dobneyresearch/PredictiveCodingNetworks_AnalogVLSIdesign/PCNchip_design/sim/results/c1_cell_transfer.png

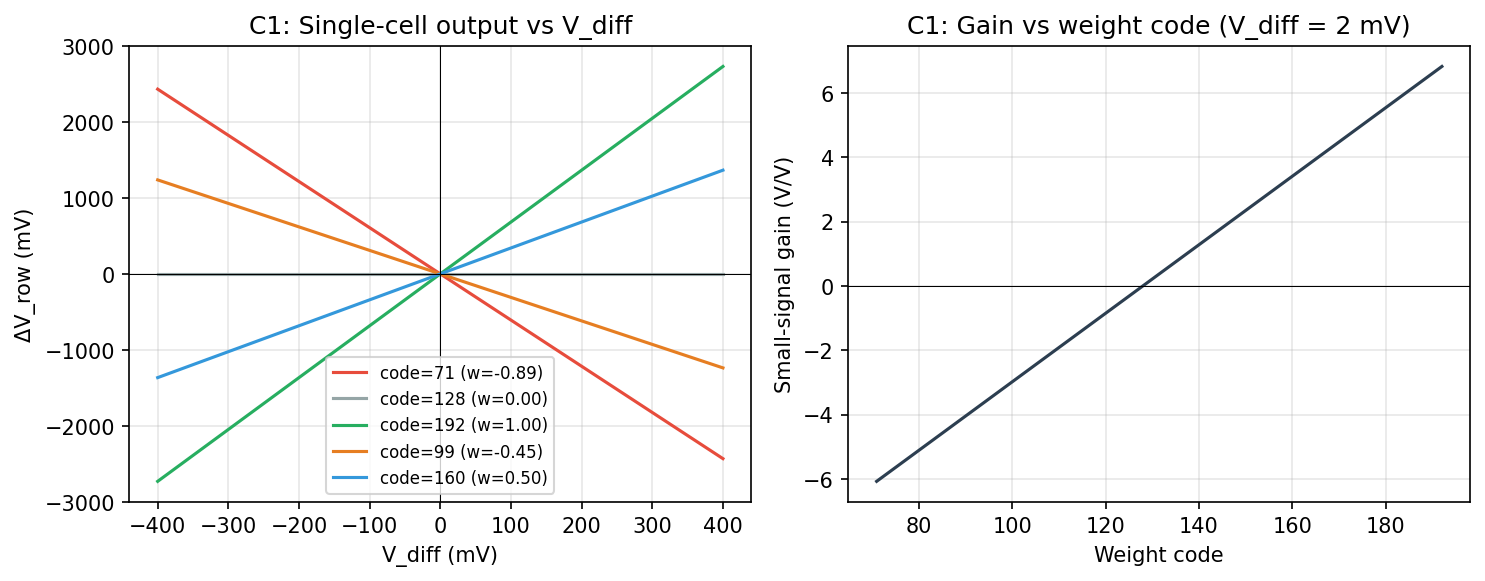
PCNchip_design/sim/results/c1_cell_transfer.png
