dobneyresearch/PredictiveCodingNetworks_AnalogVLSIdesign/PCNchip_design/sim/results/c2_kcl_summation.png

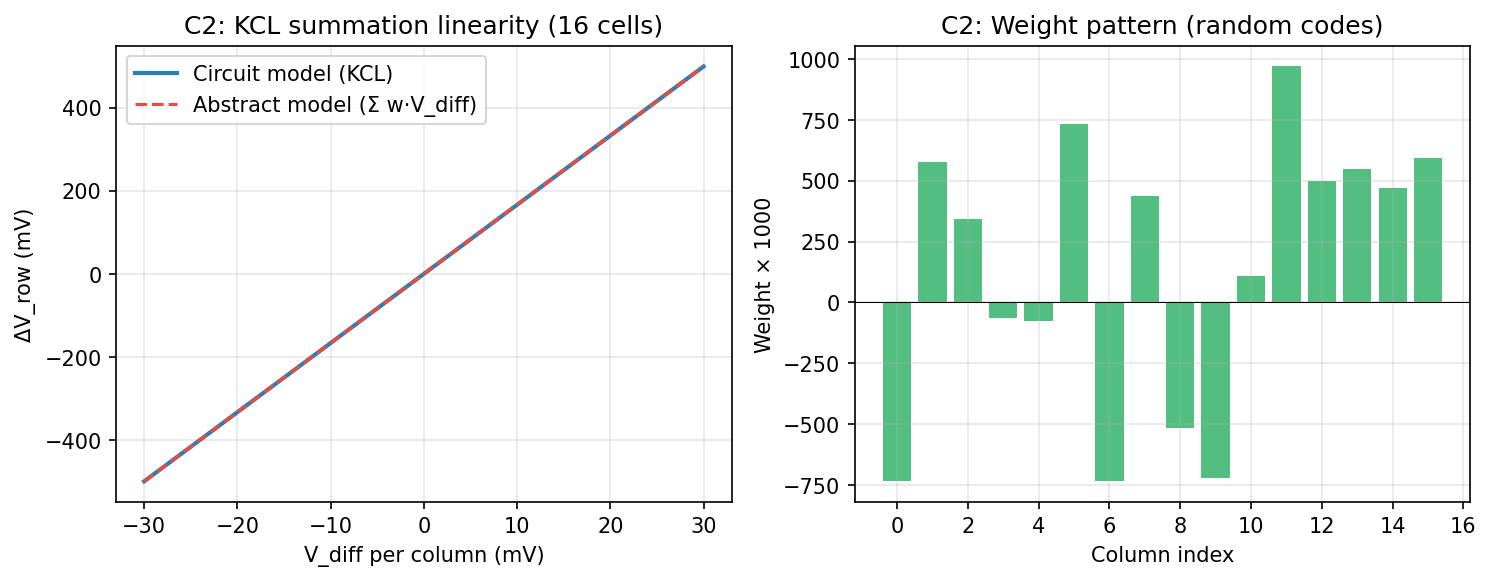
PCNchip_design/sim/results/c2_kcl_summation.png
