dobneyresearch/PredictiveCodingNetworks_AnalogVLSIdesign/PCNchip_design/sim/results/c3_spatial_cascade.png

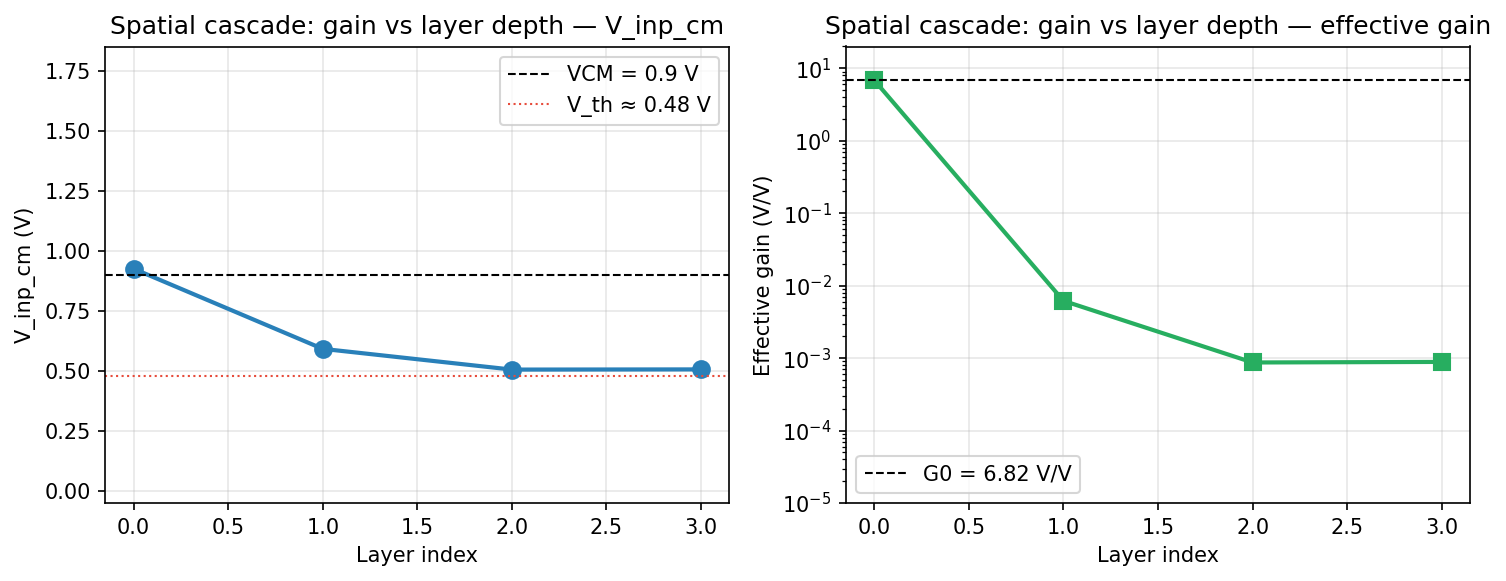
PCNchip_design/sim/results/c3_spatial_cascade.png
