dobneyresearch/PredictiveCodingNetworks_AnalogVLSIdesign/PCNchip_design/sim/results/c4_temporal_cascade.png

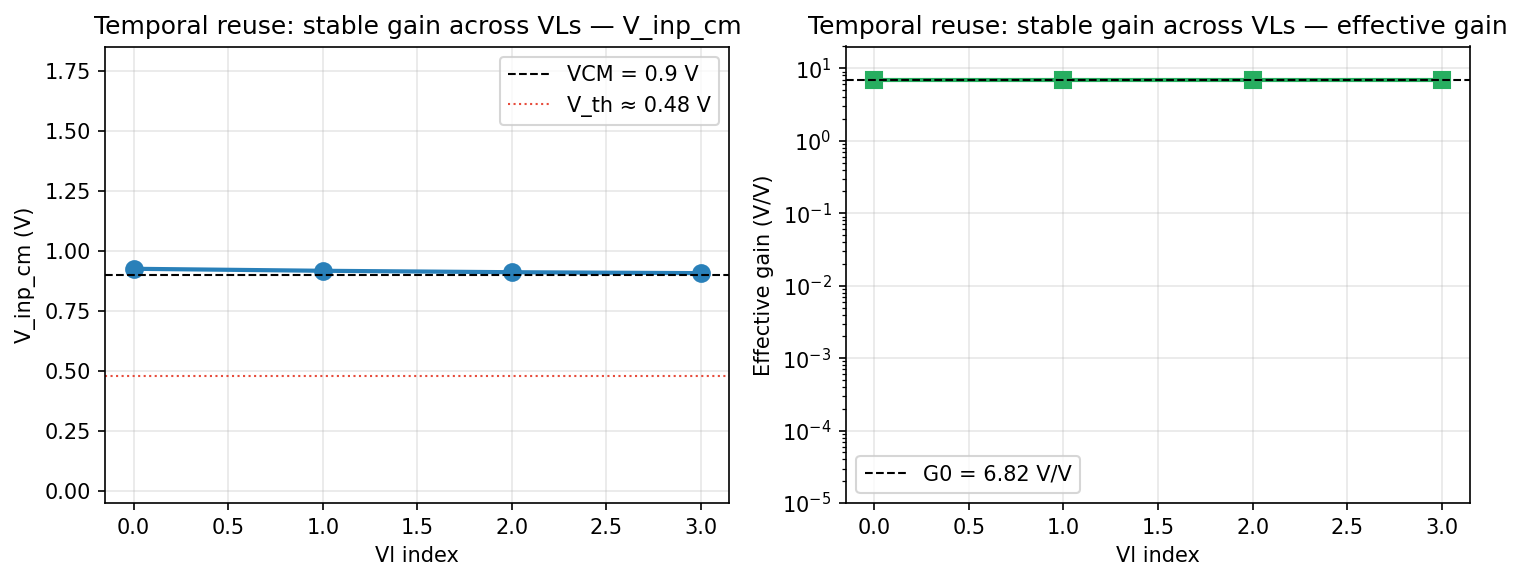
PCNchip_design/sim/results/c4_temporal_cascade.png
