dobneyresearch/PredictiveCodingNetworks_AnalogVLSIdesign/PCNchip_design/sim/results/c5_spatial_vs_temporal.png

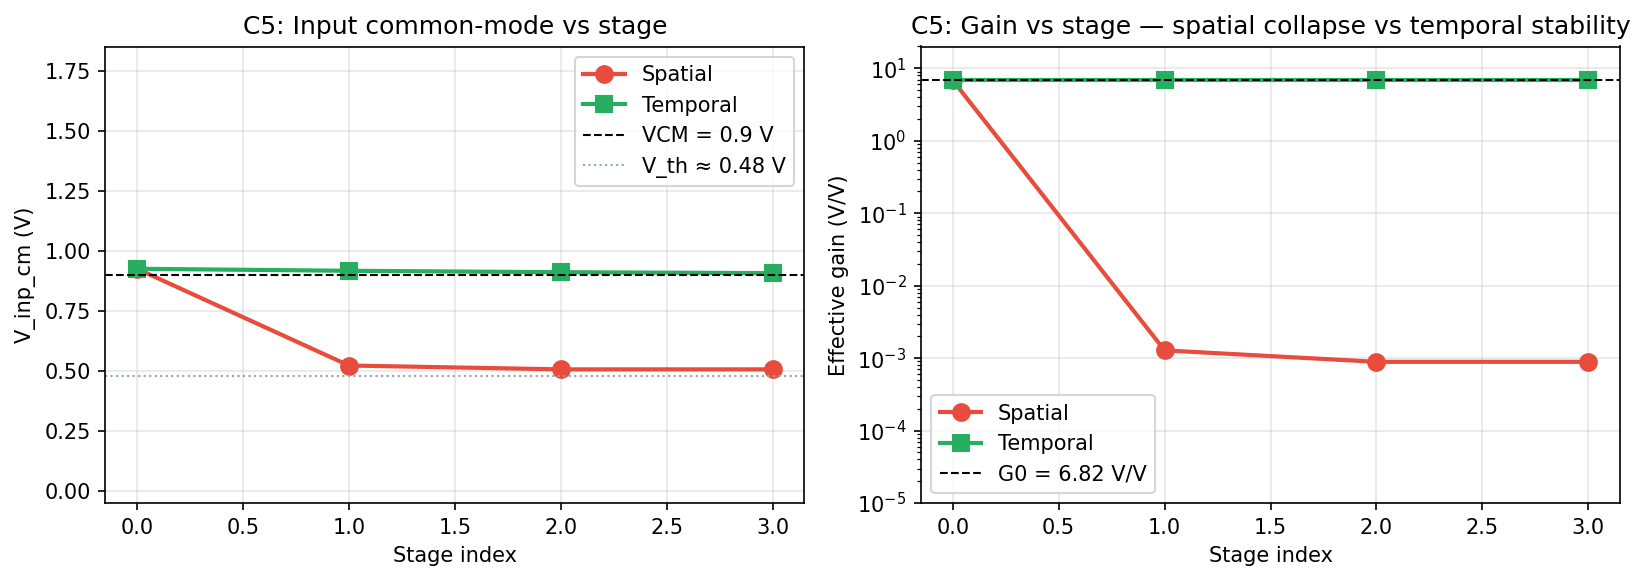
PCNchip_design/sim/results/c5_spatial_vs_temporal.png
