dobneyresearch/PredictiveCodingNetworks_AnalogVLSIdesign/PCNchip_design/sim/results/c6_quant_noise.png

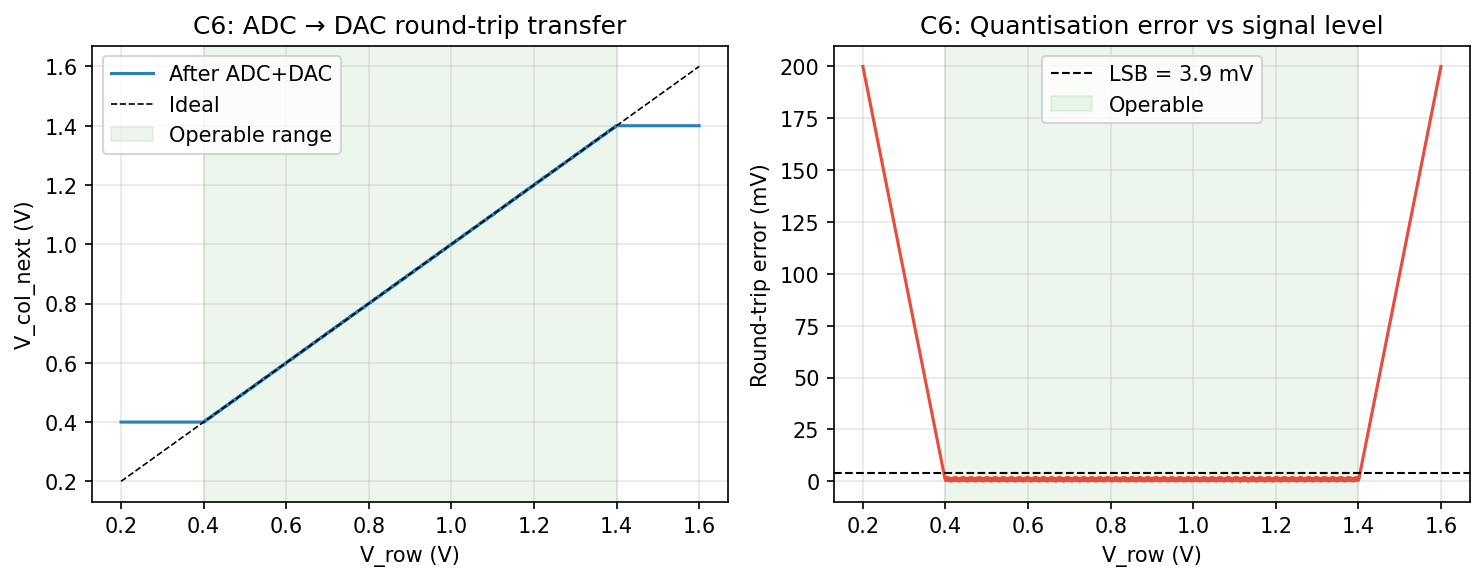
PCNchip_design/sim/results/c6_quant_noise.png
