dobneyresearch/PredictiveCodingNetworks_AnalogVLSIdesign/PCNchip_design/sim/results/c7_linearity.png

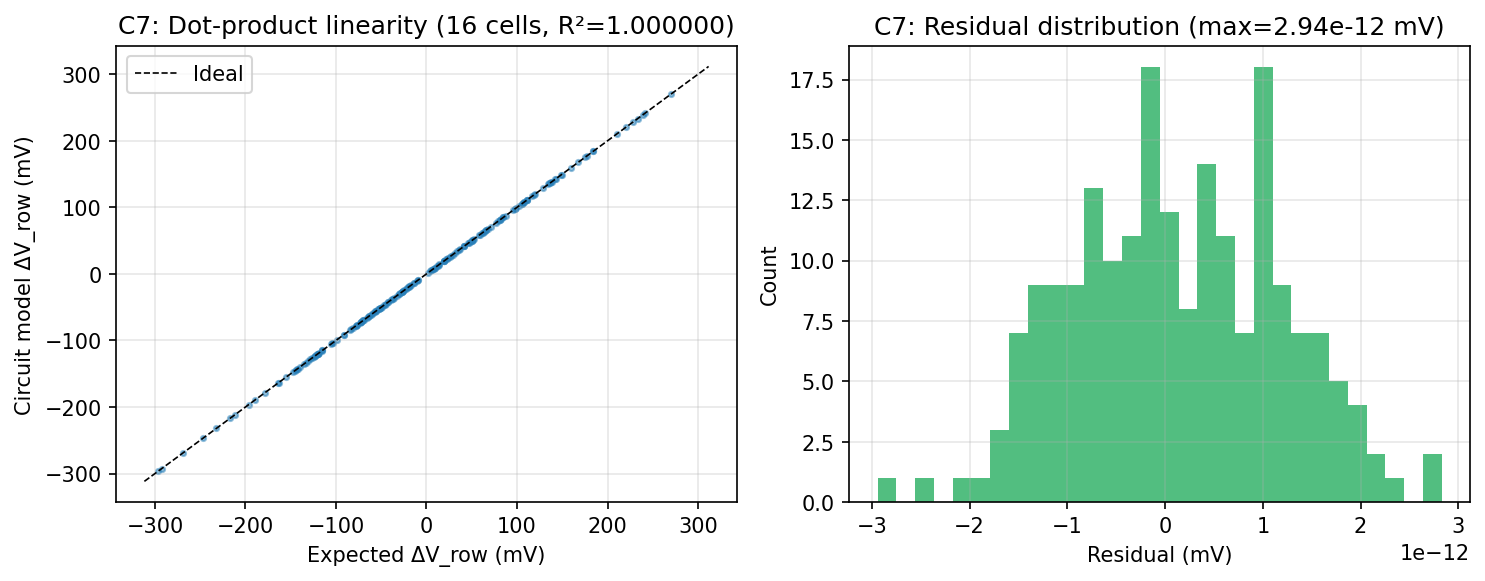
PCNchip_design/sim/results/c7_linearity.png
