dobneyresearch/PredictiveCodingNetworks_AnalogVLSIdesign/PCNchip_design/sim/results/e2_template_learning.png

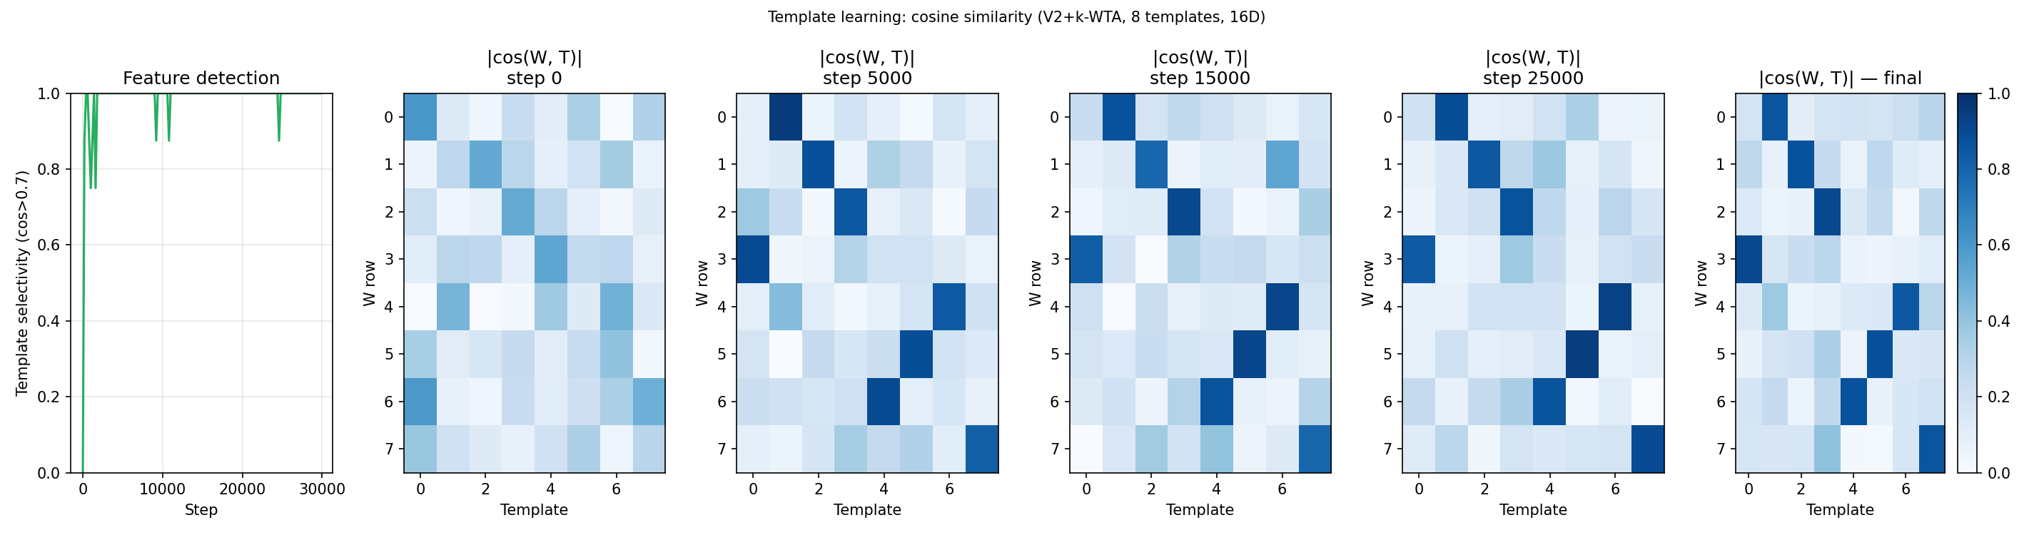
PCNchip_design/sim/results/e2_template_learning.png
