dobneyresearch/PredictiveCodingNetworks_AnalogVLSIdesign/PCNchip_design/sim/results/e3_quantisation.png

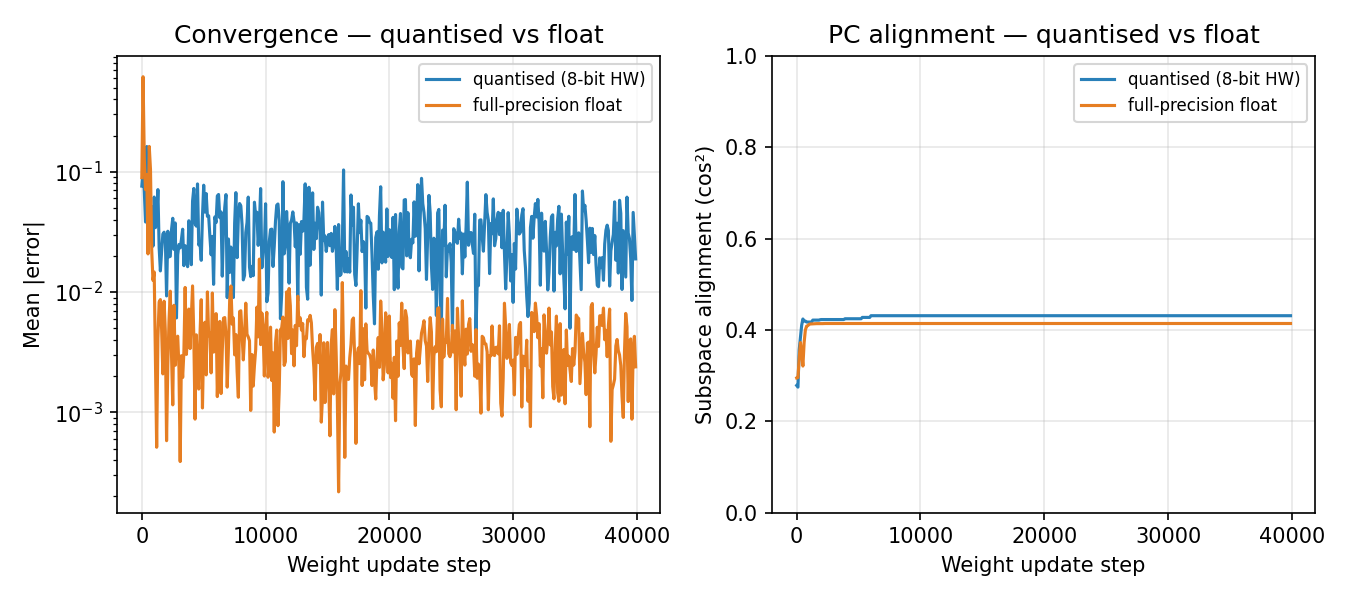
PCNchip_design/sim/results/e3_quantisation.png
