dobneyresearch/PredictiveCodingNetworks_AnalogVLSIdesign/PCNchip_design/sim/results/emnist_letters_confusion.png

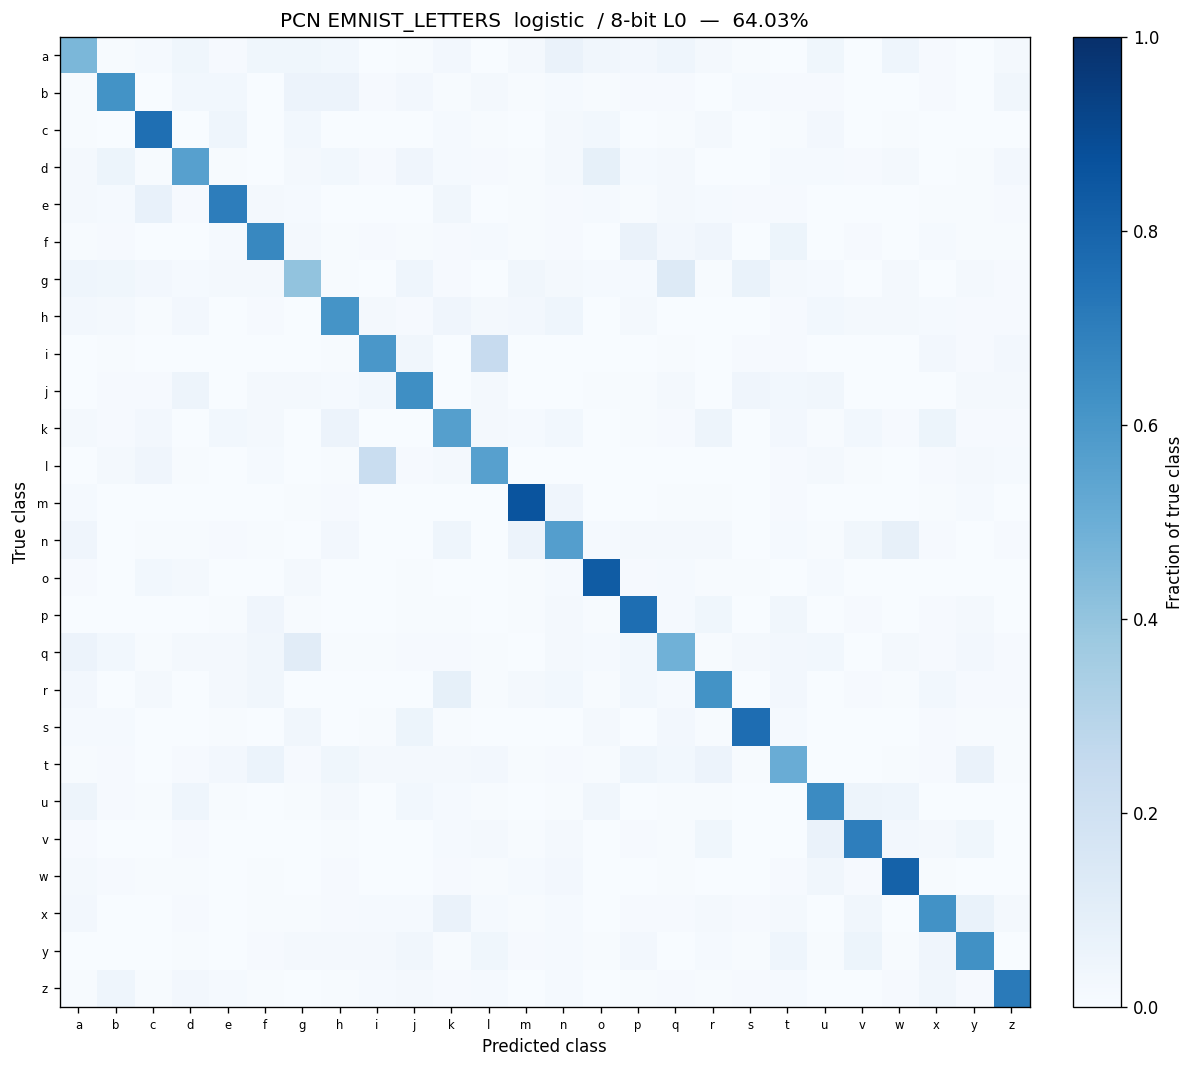
PCNchip_design/sim/results/emnist_letters_confusion.png
