dobneyresearch/PredictiveCodingNetworks_AnalogVLSIdesign/PCNchip_design/sim/results/emnist_letters_filters_l1.png

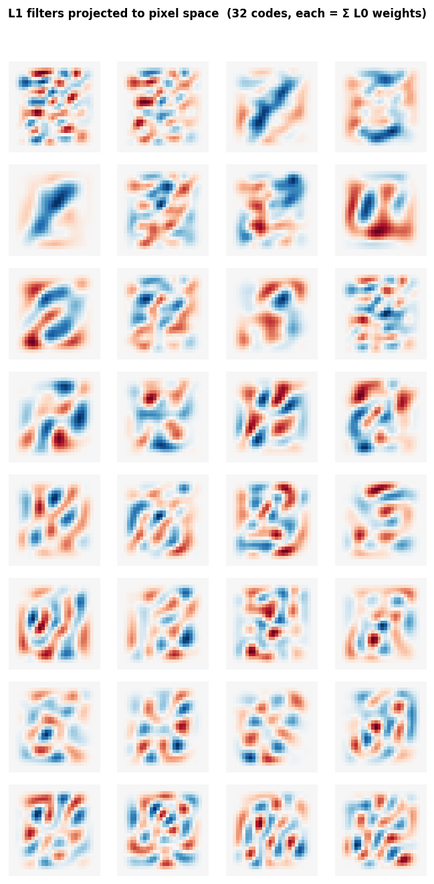
PCNchip_design/sim/results/emnist_letters_filters_l1.png
