dobneyresearch/PredictiveCodingNetworks_AnalogVLSIdesign/PCNchip_design/sim/results/emnist_letters_training.png

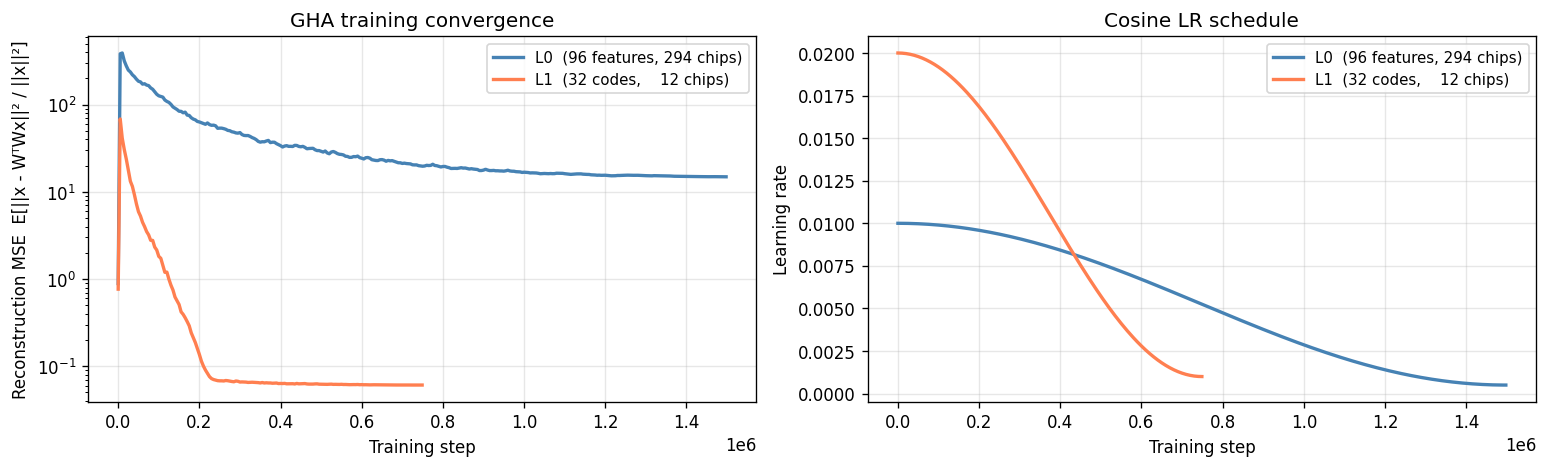
PCNchip_design/sim/results/emnist_letters_training.png
