dobneyresearch/PredictiveCodingNetworks_AnalogVLSIdesign/PCNchip_design/sim/results/mnist_confusion.png

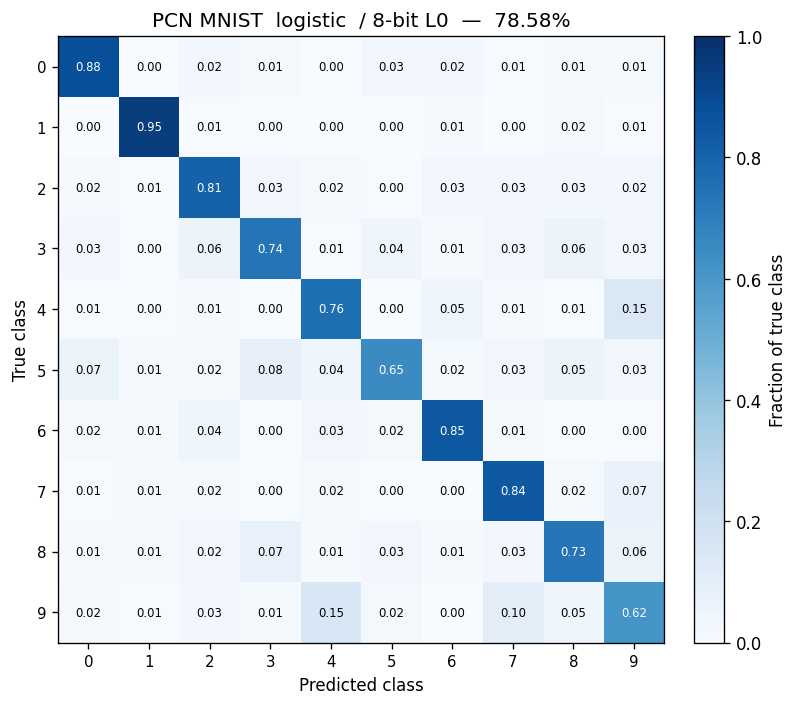
PCNchip_design/sim/results/mnist_confusion.png
