dobneyresearch/PredictiveCodingNetworks_AnalogVLSIdesign/PCNchip_design/sim/results/mnist_filters_l0.png

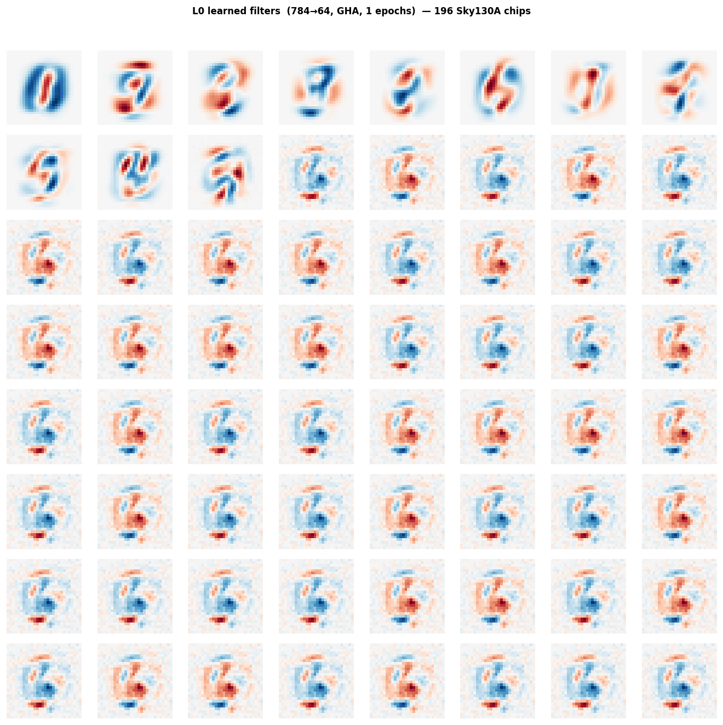
PCNchip_design/sim/results/mnist_filters_l0.png
