dobneyresearch/PredictiveCodingNetworks_AnalogVLSIdesign/PCNchip_design/sim/results/mnist_filters_l1.png

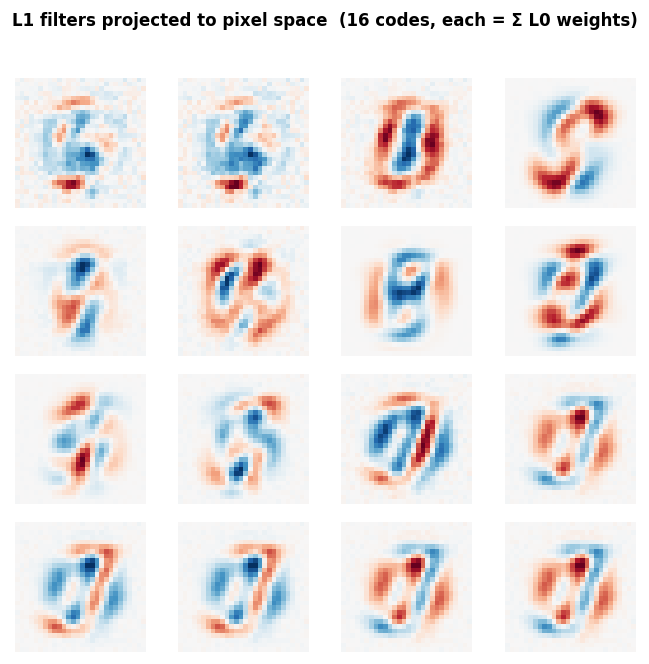
PCNchip_design/sim/results/mnist_filters_l1.png
