dobneyresearch/PredictiveCodingNetworks_AnalogVLSIdesign/PCNchip_design/sim/results/mnist_training.png

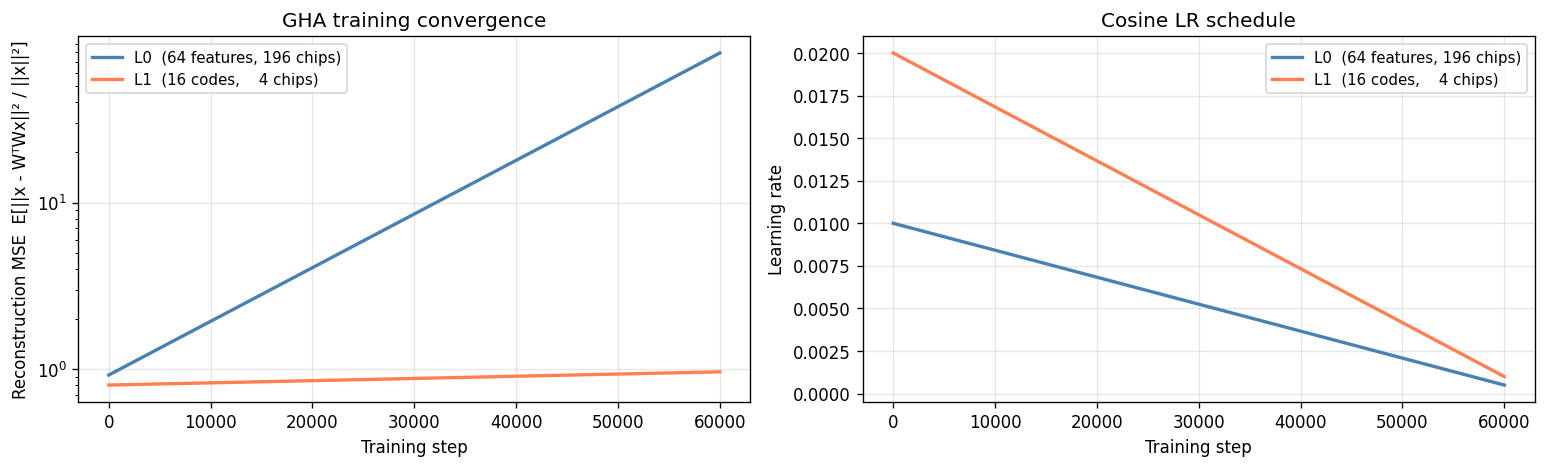
PCNchip_design/sim/results/mnist_training.png
