dobneyresearch/PredictiveCodingNetworks_AnalogVLSIdesign/PCNchip_design/layer_link_route_16.spice

* Generated by gen_array.py — DO NOT EDIT by hand.
* Regenerate: python3 gen_array.py --routing 16
* Routing layer link: 16 ascending SFs + 16×16 routing matrix.
* Routing cells: 256 XMPRED + 256 Cw_route + 256 MN4_r + 256 hebbian_mult
*
* See pred_code_networks.md §42 for design rationale.

.subckt layer_link_route_16
+ iout_lower_0  iout_lower_1  iout_lower_2  iout_lower_3  iout_lower_4  iout_lower_5  iout_lower_6  iout_lower_7  iout_lower_8  iout_lower_9  iout_lower_10  iout_lower_11  iout_lower_12  iout_lower_13  iout_lower_14  iout_lower_15
+ inp_upper_0  inp_upper_1  inp_upper_2  inp_upper_3  inp_upper_4  inp_upper_5  inp_upper_6  inp_upper_7  inp_upper_8  inp_upper_9  inp_upper_10  inp_upper_11  inp_upper_12  inp_upper_13  inp_upper_14  inp_upper_15
+ i_pred_0  i_pred_1  i_pred_2  i_pred_3  i_pred_4  i_pred_5  i_pred_6  i_pred_7  i_pred_8  i_pred_9  i_pred_10  i_pred_11  i_pred_12  i_pred_13  i_pred_14  i_pred_15
+ iout_upper_0  iout_upper_1  iout_upper_2  iout_upper_3  iout_upper_4  iout_upper_5  iout_upper_6  iout_upper_7  iout_upper_8  iout_upper_9  iout_upper_10  iout_upper_11  iout_upper_12  iout_upper_13  iout_upper_14  iout_upper_15
+ ierr_dig_0  ierr_dig_1  ierr_dig_2  ierr_dig_3  ierr_dig_4  ierr_dig_5  ierr_dig_6  ierr_dig_7  ierr_dig_8  ierr_dig_9  ierr_dig_10  ierr_dig_11  ierr_dig_12  ierr_dig_13  ierr_dig_14  ierr_dig_15
+ we_route
+ vcm_route vcm_upper vcm_iout vbias_n vdd vss

* ──────────────────────────────────────────────────────────────────────────
* ASCENDING PATH: 16 PMOS source followers  iout_lower_r → inp_upper_r
* V(inp_upper) = V(iout_lower) + |Vgs_P| ≈ +0.65V (§71 PMOS SF fix)
* ──────────────────────────────────────────────────────────────────────────
* Row 0
XMSF_0   n_sf_d_0  iout_lower_0  inp_upper_0  vdd   sky130_fd_pr__pfet_01v8  w=4  l=0.5
XMTAIL_0  n_sf_d_0  vbias_n  vss  vss   sky130_fd_pr__nfet_01v8  w=2  l=1
* Row 1
XMSF_1   n_sf_d_1  iout_lower_1  inp_upper_1  vdd   sky130_fd_pr__pfet_01v8  w=4  l=0.5
XMTAIL_1  n_sf_d_1  vbias_n  vss  vss   sky130_fd_pr__nfet_01v8  w=2  l=1
* Row 2
XMSF_2   n_sf_d_2  iout_lower_2  inp_upper_2  vdd   sky130_fd_pr__pfet_01v8  w=4  l=0.5
XMTAIL_2  n_sf_d_2  vbias_n  vss  vss   sky130_fd_pr__nfet_01v8  w=2  l=1
* Row 3
XMSF_3   n_sf_d_3  iout_lower_3  inp_upper_3  vdd   sky130_fd_pr__pfet_01v8  w=4  l=0.5
XMTAIL_3  n_sf_d_3  vbias_n  vss  vss   sky130_fd_pr__nfet_01v8  w=2  l=1
* Row 4
XMSF_4   n_sf_d_4  iout_lower_4  inp_upper_4  vdd   sky130_fd_pr__pfet_01v8  w=4  l=0.5
XMTAIL_4  n_sf_d_4  vbias_n  vss  vss   sky130_fd_pr__nfet_01v8  w=2  l=1
* Row 5
XMSF_5   n_sf_d_5  iout_lower_5  inp_upper_5  vdd   sky130_fd_pr__pfet_01v8  w=4  l=0.5
XMTAIL_5  n_sf_d_5  vbias_n  vss  vss   sky130_fd_pr__nfet_01v8  w=2  l=1
* Row 6
XMSF_6   n_sf_d_6  iout_lower_6  inp_upper_6  vdd   sky130_fd_pr__pfet_01v8  w=4  l=0.5
XMTAIL_6  n_sf_d_6  vbias_n  vss  vss   sky130_fd_pr__nfet_01v8  w=2  l=1
* Row 7
XMSF_7   n_sf_d_7  iout_lower_7  inp_upper_7  vdd   sky130_fd_pr__pfet_01v8  w=4  l=0.5
XMTAIL_7  n_sf_d_7  vbias_n  vss  vss   sky130_fd_pr__nfet_01v8  w=2  l=1
* Row 8
XMSF_8   n_sf_d_8  iout_lower_8  inp_upper_8  vdd   sky130_fd_pr__pfet_01v8  w=4  l=0.5
XMTAIL_8  n_sf_d_8  vbias_n  vss  vss   sky130_fd_pr__nfet_01v8  w=2  l=1
* Row 9
XMSF_9   n_sf_d_9  iout_lower_9  inp_upper_9  vdd   sky130_fd_pr__pfet_01v8  w=4  l=0.5
XMTAIL_9  n_sf_d_9  vbias_n  vss  vss   sky130_fd_pr__nfet_01v8  w=2  l=1
* Row 10
XMSF_10   n_sf_d_10  iout_lower_10  inp_upper_10  vdd   sky130_fd_pr__pfet_01v8  w=4  l=0.5
XMTAIL_10  n_sf_d_10  vbias_n  vss  vss   sky130_fd_pr__nfet_01v8  w=2  l=1
* Row 11
XMSF_11   n_sf_d_11  iout_lower_11  inp_upper_11  vdd   sky130_fd_pr__pfet_01v8  w=4  l=0.5
XMTAIL_11  n_sf_d_11  vbias_n  vss  vss   sky130_fd_pr__nfet_01v8  w=2  l=1
* Row 12
XMSF_12   n_sf_d_12  iout_lower_12  inp_upper_12  vdd   sky130_fd_pr__pfet_01v8  w=4  l=0.5
XMTAIL_12  n_sf_d_12  vbias_n  vss  vss   sky130_fd_pr__nfet_01v8  w=2  l=1
* Row 13
XMSF_13   n_sf_d_13  iout_lower_13  inp_upper_13  vdd   sky130_fd_pr__pfet_01v8  w=4  l=0.5
XMTAIL_13  n_sf_d_13  vbias_n  vss  vss   sky130_fd_pr__nfet_01v8  w=2  l=1
* Row 14
XMSF_14   n_sf_d_14  iout_lower_14  inp_upper_14  vdd   sky130_fd_pr__pfet_01v8  w=4  l=0.5
XMTAIL_14  n_sf_d_14  vbias_n  vss  vss   sky130_fd_pr__nfet_01v8  w=2  l=1
* Row 15
XMSF_15   n_sf_d_15  iout_lower_15  inp_upper_15  vdd   sky130_fd_pr__pfet_01v8  w=4  l=0.5
XMTAIL_15  n_sf_d_15  vbias_n  vss  vss   sky130_fd_pr__nfet_01v8  w=2  l=1
* Reference PMOS SF: vcm_iout → vcm_upper (matched shift for inn_col; §72 fix)
XMSF_ref   n_sfref_d  vcm_iout  vcm_upper  vdd   sky130_fd_pr__pfet_01v8  w=4  l=0.5
XMTAIL_ref n_sfref_d  vbias_n  vss  vss   sky130_fd_pr__nfet_01v8  w=2  l=1

* ──────────────────────────────────────────────────────────────────────────
* DESCENDING ROUTING MATRIX: 16×16 = 256 routing cells
*
* For each (dest=d, src=s):
*   XMPRED_r_d_s  — NMOS sinking from i_pred_d; gate=Vw_route_d_s
*   Cw_route_d_s  — 200fF routing weight capacitor (increase to 2p for
*                   10× slower topology timescale vs MAC weights)
*   MN4_r_d_s     — access transistor; gate=we_route
*   X_rhebb_d_s   — hebbian_mult: v_pre=inp_upper_s, vcm=vcm_route, v_post=ierr_dig_d
*                   updates Cw_route when source active AND dest has error
* ──────────────────────────────────────────────────────────────────────────

* ── Destination row 0 ── 16 source connections ──────────────────────────
XMPRED_r_0_0  i_pred_0  vw_route_0_0  vss  vss  sky130_fd_pr__nfet_01v8  w=4  l=0.35
Cw_route_0_0  vw_route_0_0  vss  200f
R_bleed_0_0  vw_route_0_0  vss  10000meg
XMN4_r_0_0  vw_route_0_0  we_route  iwrite_route_0_0  vss  sky130_fd_pr__nfet_01v8  w=0.5  l=0.5
X_rhebb_0_0  iwrite_route_0_0  inp_upper_0  ierr_dig_0  vcm_route  vdd vss  hebbian_mult
XMPRED_r_0_1  i_pred_0  vw_route_0_1  vss  vss  sky130_fd_pr__nfet_01v8  w=4  l=0.35
Cw_route_0_1  vw_route_0_1  vss  200f
R_bleed_0_1  vw_route_0_1  vss  10000meg
XMN4_r_0_1  vw_route_0_1  we_route  iwrite_route_0_1  vss  sky130_fd_pr__nfet_01v8  w=0.5  l=0.5
X_rhebb_0_1  iwrite_route_0_1  inp_upper_1  ierr_dig_0  vcm_route  vdd vss  hebbian_mult
XMPRED_r_0_2  i_pred_0  vw_route_0_2  vss  vss  sky130_fd_pr__nfet_01v8  w=4  l=0.35
Cw_route_0_2  vw_route_0_2  vss  200f
R_bleed_0_2  vw_route_0_2  vss  10000meg
XMN4_r_0_2  vw_route_0_2  we_route  iwrite_route_0_2  vss  sky130_fd_pr__nfet_01v8  w=0.5  l=0.5
X_rhebb_0_2  iwrite_route_0_2  inp_upper_2  ierr_dig_0  vcm_route  vdd vss  hebbian_mult
XMPRED_r_0_3  i_pred_0  vw_route_0_3  vss  vss  sky130_fd_pr__nfet_01v8  w=4  l=0.35
Cw_route_0_3  vw_route_0_3  vss  200f
R_bleed_0_3  vw_route_0_3  vss  10000meg
XMN4_r_0_3  vw_route_0_3  we_route  iwrite_route_0_3  vss  sky130_fd_pr__nfet_01v8  w=0.5  l=0.5
X_rhebb_0_3  iwrite_route_0_3  inp_upper_3  ierr_dig_0  vcm_route  vdd vss  hebbian_mult
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
Cw_route_3_15  vw_route_3_15  vss  200f
R_bleed_3_15  vw_route_3_15  vss  10000meg
XMN4_r_3_15  vw_route_3_15  we_route  iwrite_route_3_15  vss  sky130_fd_pr__nfet_01v8  w=0.5  l=0.5
X_rhebb_3_15  iwrite_route_3_15  inp_upper_15  ierr_dig_3  vcm_route  vdd vss  hebbian_mult
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
