dobneyresearch/PredictiveCodingNetworks_AnalogVLSIdesign/PCNchip_design/pcn_array_16x32.spice

* Generated by gen_array.py — DO NOT EDIT by hand.
* Regenerate: python3 gen_array.py 16 32
* PCN weight array: 16 rows × 32 columns = 512 MAC cells.
*
* Port convention:
*   inp_col_c / inn_col_c  — differential column inputs (c = 0..31)
*   iout_row_r             — row KCL accumulation bus (r = 0..15)
*   we_row_r               — Hebbian write enable for row r (from hebb_ctrl)
*   v_post_r               — post-synaptic signal for row r (from precision_gate.ierr_dig)
*   vcm vdd vss
*
* Internal nodes:
*   vw_r_c                 — weight capacitor voltage for cell [r][c]
*   iwrite_r_c             — Hebbian update current (hebbian_mult → mac_cell.iwrite)

.subckt pcn_array_16x32
+ inp_col_0 inn_col_0 inp_col_1 inn_col_1 inp_col_2 inn_col_2 inp_col_3 inn_col_3 inp_col_4 inn_col_4 inp_col_5 inn_col_5 inp_col_6 inn_col_6 inp_col_7 inn_col_7 inp_col_8 inn_col_8 inp_col_9 inn_col_9 inp_col_10 inn_col_10 inp_col_11 inn_col_11 inp_col_12 inn_col_12 inp_col_13 inn_col_13 inp_col_14 inn_col_14 inp_col_15 inn_col_15 inp_col_16 inn_col_16 inp_col_17 inn_col_17 inp_col_18 inn_col_18 inp_col_19 inn_col_19 inp_col_20 inn_col_20 inp_col_21 inn_col_21 inp_col_22 inn_col_22 inp_col_23 inn_col_23 inp_col_24 inn_col_24 inp_col_25 inn_col_25 inp_col_26 inn_col_26 inp_col_27 inn_col_27 inp_col_28 inn_col_28 inp_col_29 inn_col_29 inp_col_30 inn_col_30 inp_col_31 inn_col_31
+ iout_row_0 iout_row_1 iout_row_2 iout_row_3 iout_row_4 iout_row_5 iout_row_6 iout_row_7 iout_row_8 iout_row_9 iout_row_10 iout_row_11 iout_row_12 iout_row_13 iout_row_14 iout_row_15
+ we_row_0 we_row_1 we_row_2 we_row_3 we_row_4 we_row_5 we_row_6 we_row_7 we_row_8 we_row_9 we_row_10 we_row_11 we_row_12 we_row_13 we_row_14 we_row_15
+ v_post_0 v_post_1 v_post_2 v_post_3 v_post_4 v_post_5 v_post_6 v_post_7 v_post_8 v_post_9 v_post_10 v_post_11 v_post_12 v_post_13 v_post_14 v_post_15
+ vcm vdd vss

* ── MAC cells ────────────────────────────────────────────────────────────────
* X_mac_r_c  iout_row_r  inp_col_c  inn_col_c  vw_r_c  iwrite_r_c  we_row_r  vdd vss  mac_cell
X_mac_0_0  iout_row_0  inp_col_0  inn_col_0  vw_0_0  iwrite_0_0  we_row_0  vdd vss  mac_cell
X_mac_0_1  iout_row_0  inp_col_1  inn_col_1  vw_0_1  iwrite_0_1  we_row_0  vdd vss  mac_cell
X_mac_0_2  iout_row_0  inp_col_2  inn_col_2  vw_0_2  iwrite_0_2  we_row_0  vdd vss  mac_cell
X_mac_0_3  iout_row_0  inp_col_3  inn_col_3  vw_0_3  iwrite_0_3  we_row_0  vdd vss  mac_cell
X_mac_0_4  iout_row_0  inp_col_4  inn_col_4  vw_0_4  iwrite_0_4  we_row_0  vdd vss  mac_cell
X_mac_0_5  iout_row_0  inp_col_5  inn_col_5  vw_0_5  iwrite_0_5  we_row_0  vdd vss  mac_cell
X_mac_0_6  iout_row_0  inp_col_6  inn_col_6  vw_0_6  iwrite_0_6  we_row_0  vdd vss  mac_cell
X_mac_0_7  iout_row_0  inp_col_7  inn_col_7  vw_0_7  iwrite_0_7  we_row_0  vdd vss  mac_cell
X_mac_0_8  iout_row_0  inp_col_8  inn_col_8  vw_0_8  iwrite_0_8  we_row_0  vdd vss  mac_cell
X_mac_0_9  iout_row_0  inp_col_9  inn_col_9  vw_0_9  iwrite_0_9  we_row_0  vdd vss  mac_cell
X_mac_0_10  iout_row_0  inp_col_10  inn_col_10  vw_0_10  iwrite_0_10  we_row_0  vdd vss  mac_cell
X_mac_0_11  iout_row_0  inp_col_11  inn_col_11  vw_0_11  iwrite_0_11  we_row_0  vdd vss  mac_cell
X_mac_0_12  iout_row_0  inp_col_12  inn_col_12  vw_0_12  iwrite_0_12  we_row_0  vdd vss  mac_cell
X_mac_0_13  iout_row_0  inp_col_13  inn_col_13  vw_0_13  iwrite_0_13  we_row_0  vdd vss  mac_cell
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
X_mac_8_18  iout_row_8  inp_col_18  inn_col_18  vw_8_18  iwrite_8_18  we_row_8  vdd vss  mac_cell
X_mac_8_19  iout_row_8  inp_col_19  inn_col_19  vw_8_19  iwrite_8_19  we_row_8  vdd vss  mac_cell
X_mac_8_20  iout_row_8  inp_col_20  inn_col_20  vw_8_20  iwrite_8_20  we_row_8  vdd vss  mac_cell
X_mac_8_21  iout_row_8  inp_col_21  inn_col_21  vw_8_21  iwrite_8_21  we_row_8  vdd vss  mac_cell
X_mac_8_22  iout_row_8  inp_col_22  inn_col_22  vw_8_22  iwrite_8_22  we_row_8  vdd vss  mac_cell
X_mac_8_23  iout_row_8  inp_col_23  inn_col_23  vw_8_23  iwrite_8_23  we_row_8  vdd vss  mac_cell
X_mac_8_24  iout_row_8  inp_col_24  inn_col_24  vw_8_24  iwrite_8_24  we_row_8  vdd vss  mac_cell
X_mac_8_25  iout_row_8  inp_col_25  inn_col_25  vw_8_25  iwrite_8_25  we_row_8  vdd vss  mac_cell
X_mac_8_26  iout_row_8  inp_col_26  inn_col_26  vw_8_26  iwrite_8_26  we_row_8  vdd vss  mac_cell
X_mac_8_27  iout_row_8  inp_col_27  inn_col_27  vw_8_27  iwrite_8_27  we_row_8  vdd vss  mac_cell
X_mac_8_28  iout_row_8  inp_col_28  inn_col_28  vw_8_28  iwrite_8_28  we_row_8  vdd vss  mac_cell
X_mac_8_29  iout_row_8  inp_col_29  inn_col_29  vw_8_29  iwrite_8_29  we_row_8  vdd vss  mac_cell
X_mac_8_30  iout_row_8  inp_col_30  inn_col_30  vw_8_30  iwrite_8_30  we_row_8  vdd vss  mac_cell
X_mac_8_31  iout_row_8  inp_col_31  inn_col_31  vw_8_31  iwrite_8_31  we_row_8  vdd vss  mac_cell
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
